batti/tng-bricklet4/(commit log)

2019-11-29 first hardware prototype
    [bricklets.sch, inputs.sch, tf.kicad_pcb, tf.sch]
2019-11-29 fix names
    [bricklet4.kicad_pcb, bricklet4.sch]
2019-12-10 fix name
    [bricklet4.kicad_pcb]
2019-12-23 update rgb led drill diameter
    [bricklet4.kicad_pcb]
2020-01-14 fix 3d model settings
    [bricklet4.kicad_pcb]
2020-03-02 add hook footprint
    [bricklet4.kicad_pcb]
2020-05-14 fix values
    [bricklet4.kicad_pcb, bricklet4.sch]
2020-05-14 specify value
    [bricklet4.kicad_pcb, bricklet4.sch]
