batti/tng-bricklet4/(notices)

Notices in the files:
hardware/inputs.sch:
Licensed under CERN OHL v.1.1
Copyright (©) 2019, B.Nordmeyer
Copyright Tinkerforge GmbH 2019.
This documentation describes Open Hardware and is licensed under the
CERN OHL v. 1.1.
